AnenaX/IoT-Integrated-Automated-Gate-System/docs/L1 - GANTT.pdf

ée

# z SAE6IOM01-Mettre en place un réseau IoT répondant à un cahier des charges

Entrez le nom de la société dans la cellule B2.

Entrez le nom du chef de projet dans la cellule B3. Entrez la date de début du projet dans la cellule E3. Début du projet : l’étiquette figure dans la cellule C3. se
m

1

Le | 2 3 | 4 | 5 6 7 8 | 9 10 11 12 13 14 15 | 16 17 18 19 20 21 22 | 23 24 25 26 27 28 1 | 2 3 4 5 6 7 8 | 9 10 11 12 13 14 15 | 16 17 18 19 20 21 22
tt
e
TÂCHE | DURÉE | DÉBUT | FIN | l | m | m | j | v | s | d | l | m | m | j | v | s | d | l | m | m | j | v | s | d | l | m | m | j | v | s | d | l | m | m | j | v | s | d | l | m | m | j | v | s | d | l | m | m | j | v | s | d

ce
llu | 4/2/26 | 4/2/26

ce
llu | 4/2/26 | 4/2/26

s
lig
| | 4/2/26 | 5/2/26
| | 5/2/26 | 5/2/26
| | 5/2/26 | 6/2/26
| | 9/2/26 | 18/2/26

ce
llu
| | 19/2/26 | 25/2/26
| | 26/2/26 | 6/3/26
| | 9/3/26 | 10/3/26
| | 10/3/26 | 10/3/26
| | 10/3/26 | 15/3/26
Rédaction rapport final et oral | | 9/2/26 | 20/3/26

Exemple de bloc de titre de phase

Exemple de bloc de titre de phase

Ceci est une ligne vide.

mar, 2/3/2026

2 févr 2026 | 9 févr 2026 | 16 févr 2026 | 23 févr 2026

Début du projet :

Semaine d’affichage :

2 mars 2026 | 9 mars 2026 | 16 mars 2026

Mise en place du GANTT

Étude du systéme demandé

Cahier des charges techniques

Séléction des différents modules nécessaires

Mise en forme du devis

Liaison RPI4

Assemblage logiciels et composants

Création de la télécommande (logiciel)

Mesures et prototypage de l'ensemble

Assemblage matériel

Mesures IR (Portée et consommation)
