AnenaX/IoT-Integrated-Automated-Gate-System/docs/src/Diagramme bete a cornes.drawio.png

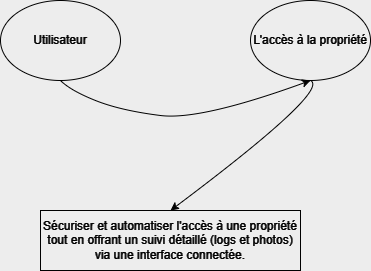
docs/src/Diagramme bete a cornes.drawio.png
