AnenaX/IoT-Integrated-Automated-Gate-System/docs/src/diagramme des exigences techniques.drawio.png

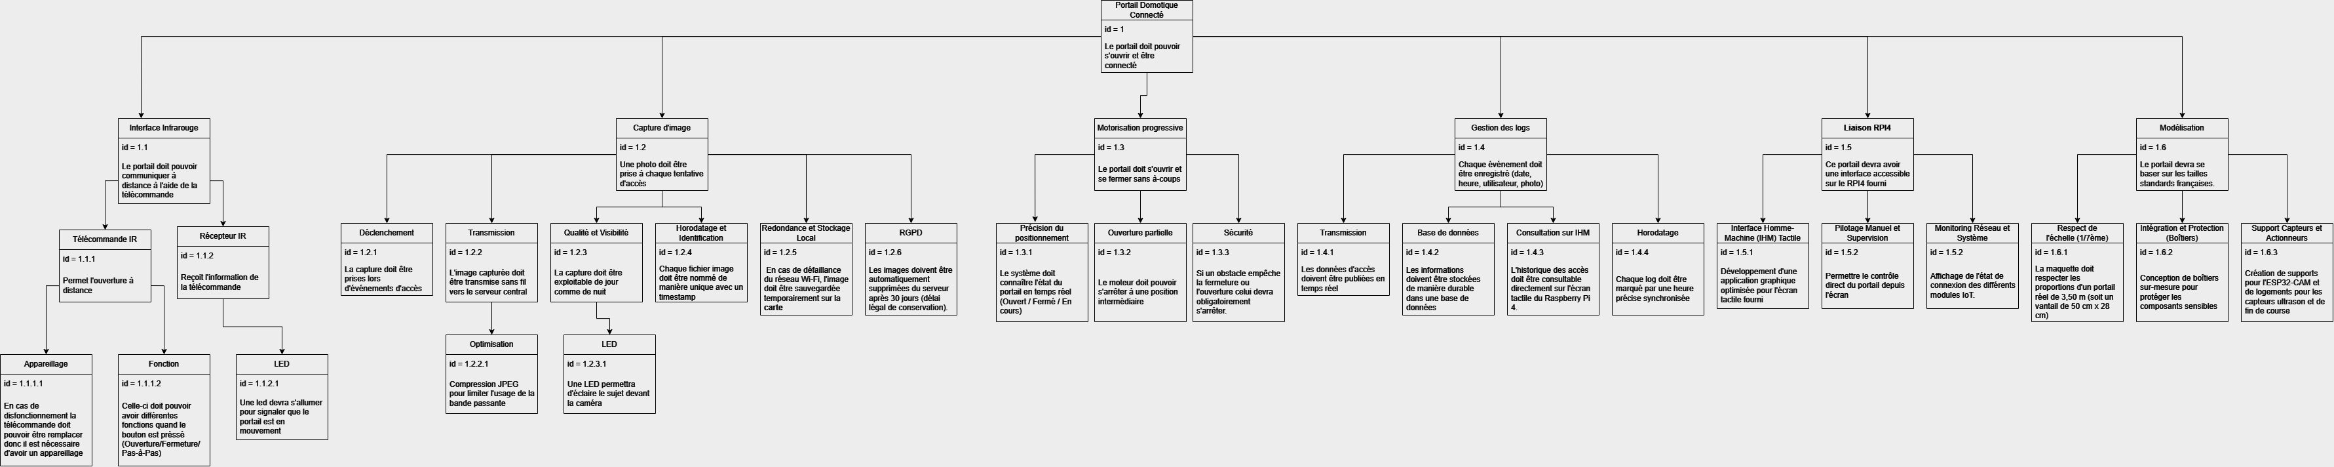
docs/src/diagramme des exigences techniques.drawio.png
