AnenaX/IoT-Integrated-Automated-Gate-System/docs/src/diagramme pieuvre.drawio.png

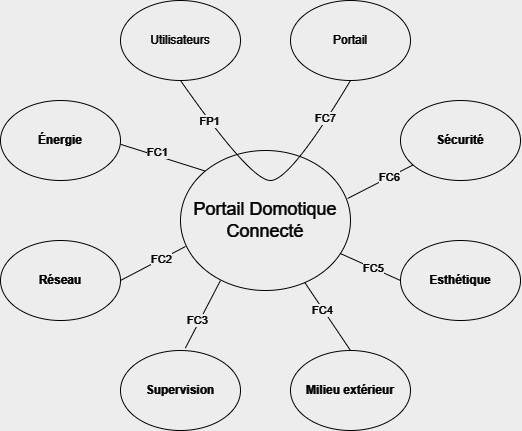
docs/src/diagramme pieuvre.drawio.png
