AnenaX/IoT-Integrated-Automated-Gate-System/docs/src/exigences-part1.png

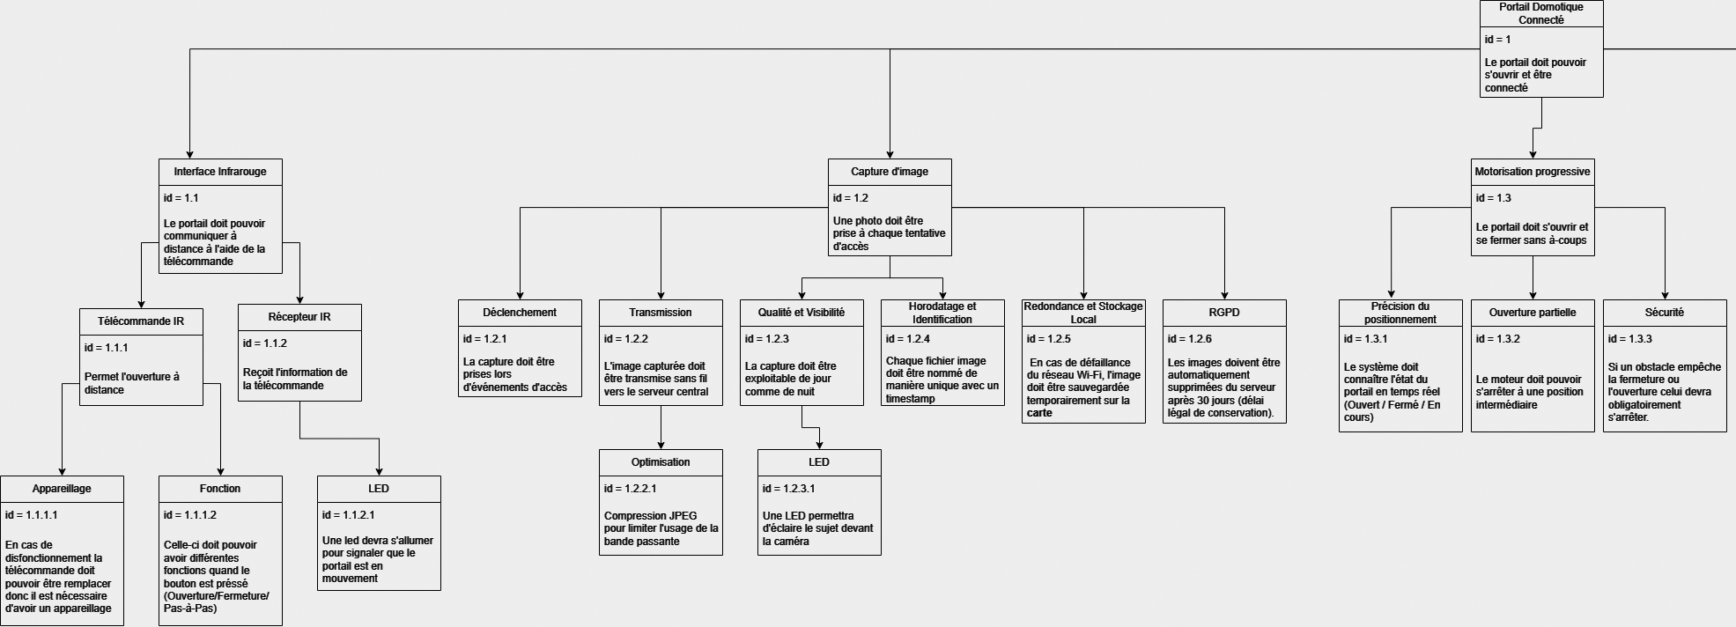
docs/src/exigences-part1.png
