AnenaX/IoT-Integrated-Automated-Gate-System/docs/src/exigences-part2.png

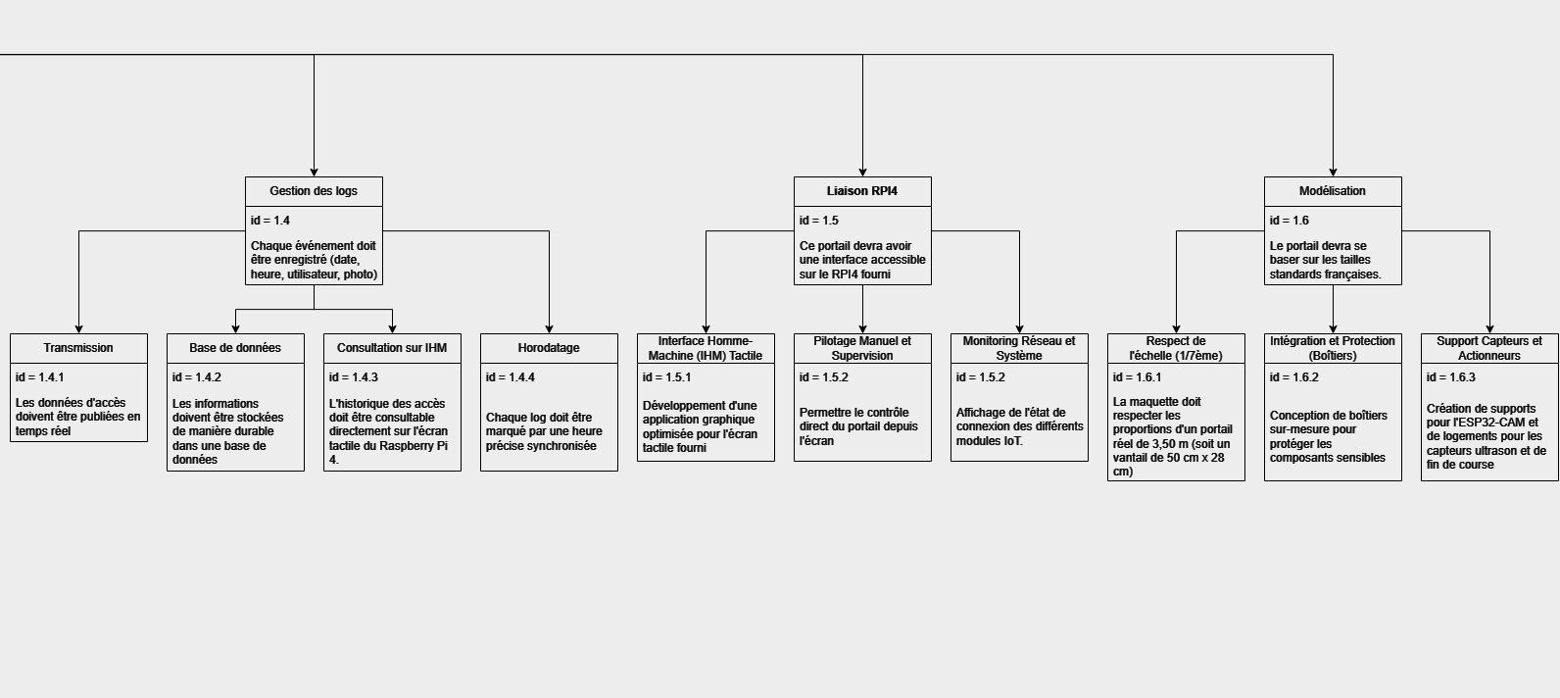
docs/src/exigences-part2.png
