AnenaX/IoT-Integrated-Automated-Gate-System/docs/src/maquette elctronique.drawio.png

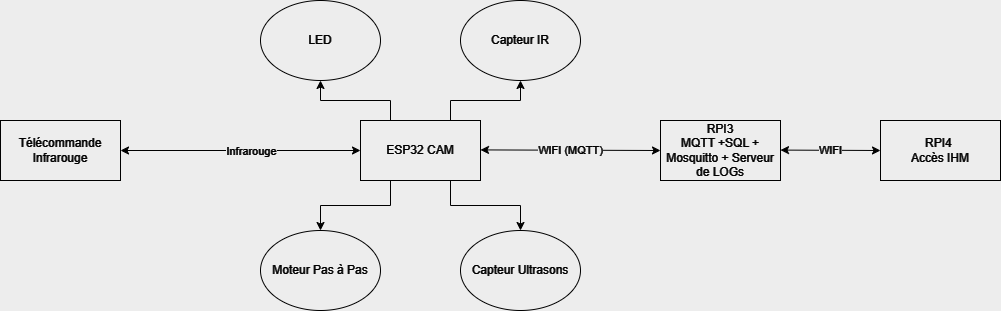
docs/src/maquette elctronique.drawio.png
