AnenaX/IoT-Integrated-Automated-Gate-System/docs/src/Rail.png

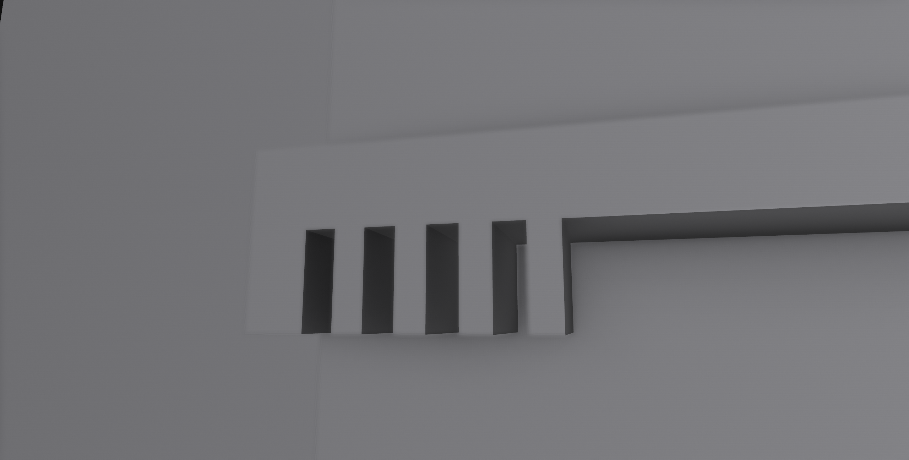
docs/src/Rail.png
