AnenaX/IoT-Integrated-Automated-Gate-System/docs/src/Rendu 3d.png

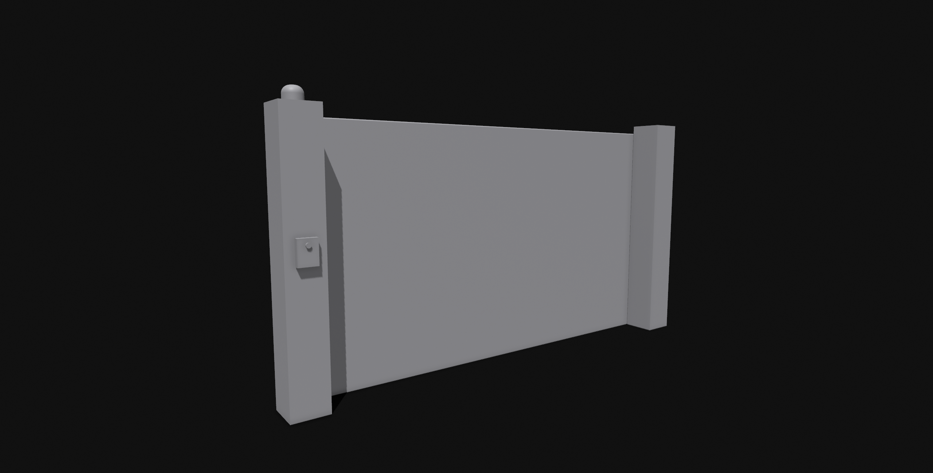
docs/src/Rendu 3d.png
