AnenaX/IoT-Integrated-Automated-Gate-System/docs/L4.5 - Materials.pdf

XXXXXXX
XXXXXXX

# Liste du matériel fourni

Modules | Quantité
RPI3 | 1
ESP32 | 1
ESP32 CAM | 2
Moteur Pas à Pas | 1
SR04M | 1
KY-022 | 1
KY-005 | 1
SD 32Go | 1
Batterie | 1

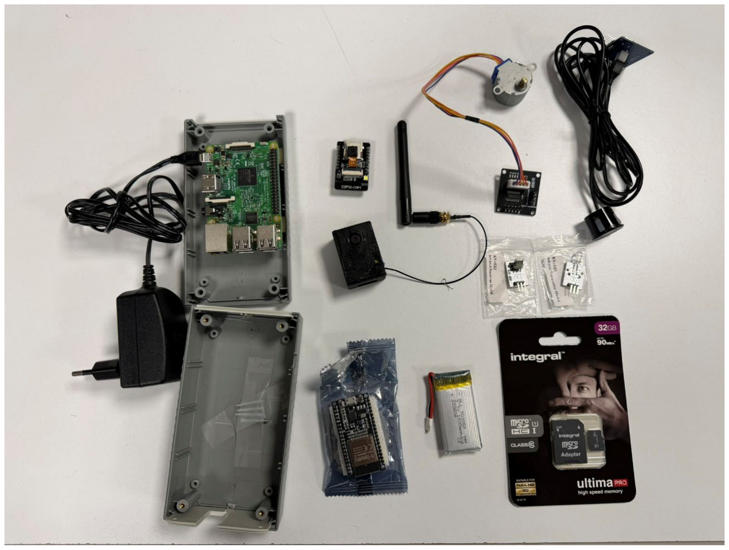
[picture p9: figure]
