AnenaX/IoT-Integrated-Automated-Gate-System/hardware/Doors/guide.stl

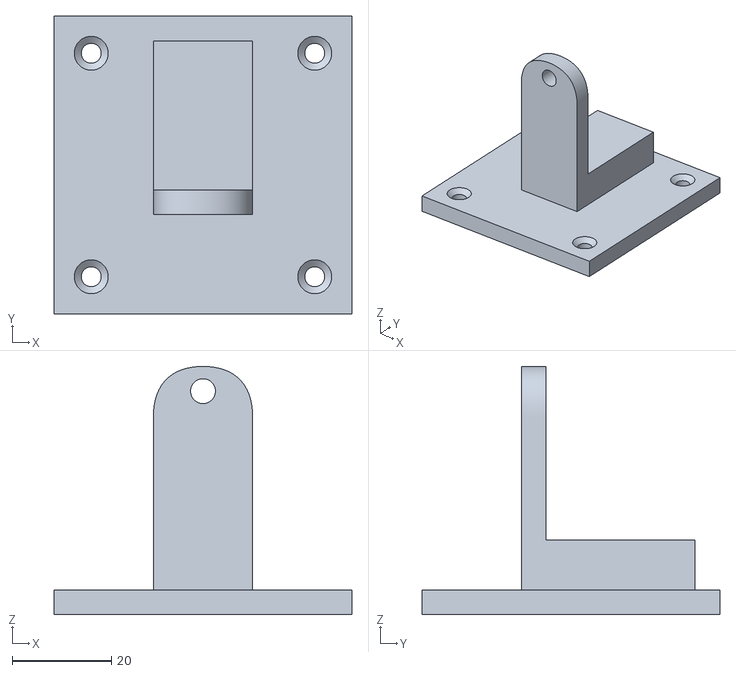
[picture p13: CAD file, 2026-03-16]
hardware/Doors/guide.stl
60.0 x 60.0 x 50.0
