AnenaX/IoT-Integrated-Automated-Gate-System/hardware/Doors/rpi case bottom.stl

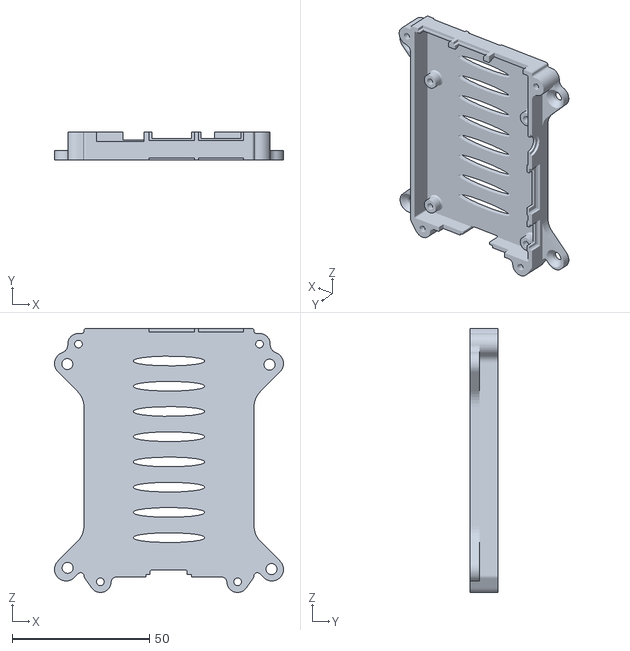
[picture p14: CAD file, 2026-03-16]
hardware/Doors/rpi case bottom.stl
83.5 x 10.3 x 96.2
