AnenaX/IoT-Integrated-Automated-Gate-System/hardware/Doors/rail 18cm.stl

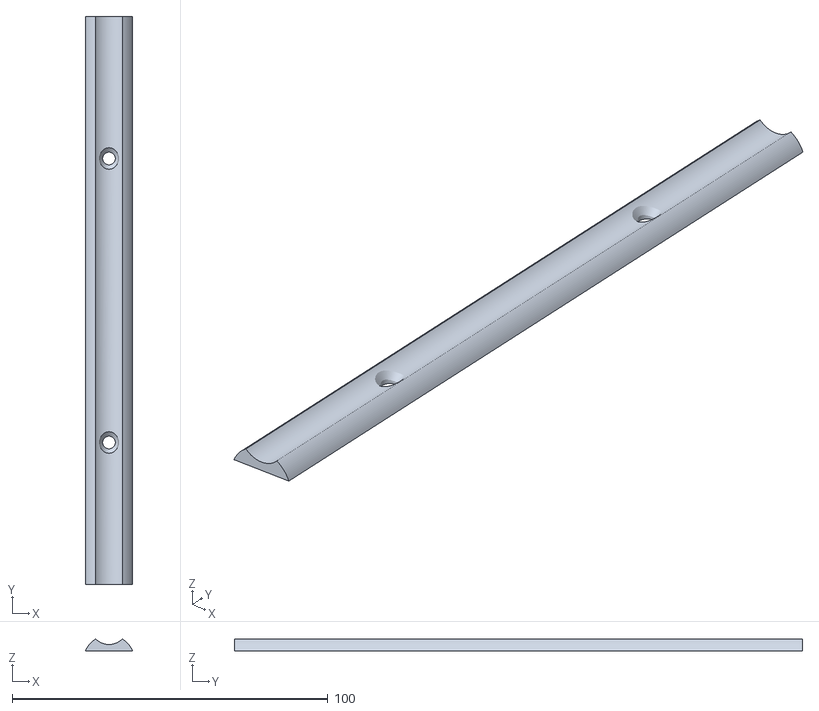
[picture p15: CAD file, 2026-03-16]
hardware/Doors/rail 18cm.stl
15.0 x 180.0 x 3.83
