AnenaX/IoT-Integrated-Automated-Gate-System/hardware/Doors/linear gear 9,2cm.stl

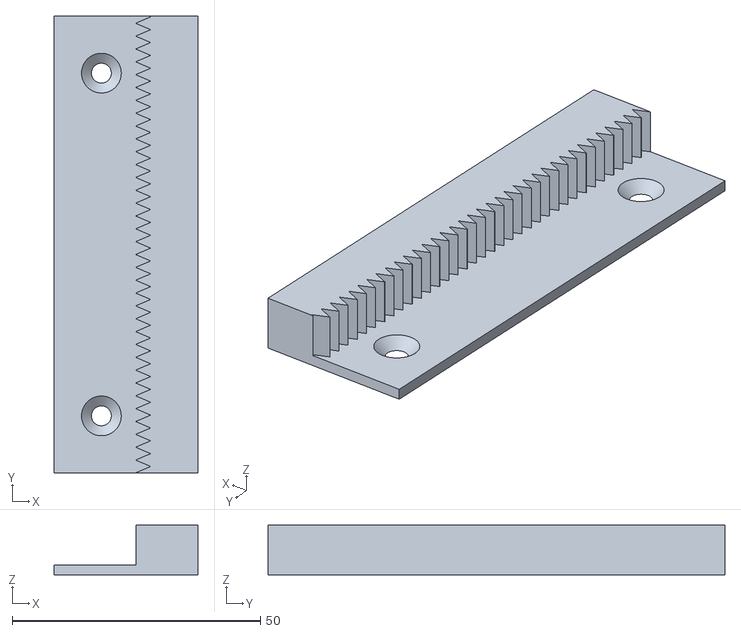
[picture p16: CAD file, 2026-03-16]
hardware/Doors/linear gear 9,2cm.stl
28.9 x 92.0 x 10.0
