AnenaX/IoT-Integrated-Automated-Gate-System/hardware/Doors/linear gear 14cm.stl

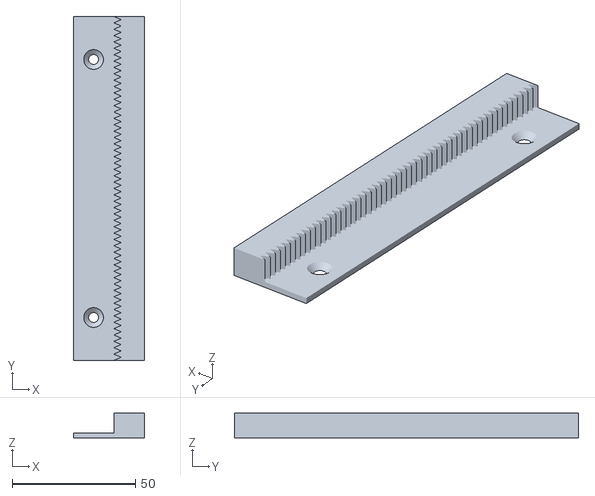
[picture p17: CAD file, 2026-03-16]
hardware/Doors/linear gear 14cm.stl
28.9 x 139.7 x 10.0
