AnenaX/IoT-Integrated-Automated-Gate-System/hardware/Doors/gear.stl

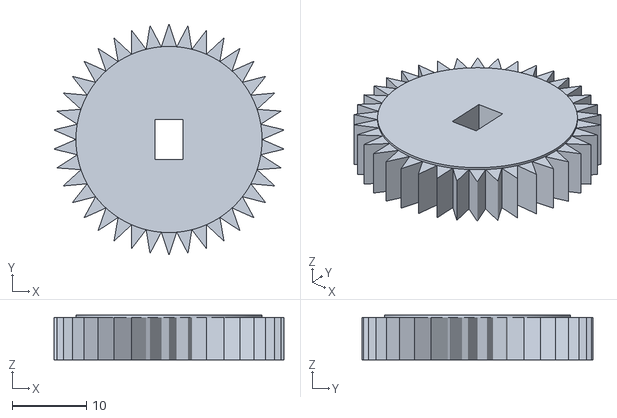
[picture p18: CAD file, 2026-03-16]
hardware/Doors/gear.stl
30.9 x 31.0 x 6.00
