AnenaX/IoT-Integrated-Automated-Gate-System/hardware/Doors/rail under the gate.stl

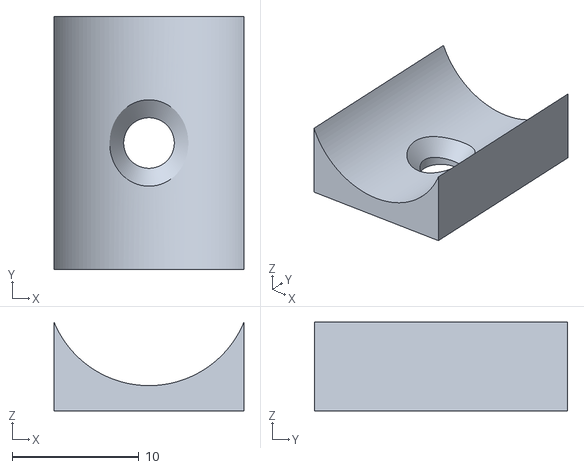
[picture p19: CAD file, 2026-03-16]
hardware/Doors/rail under the gate.stl
15.0 x 20.0 x 7.00
