AnenaX/IoT-Integrated-Automated-Gate-System/hardware/Doors/support motor.stl

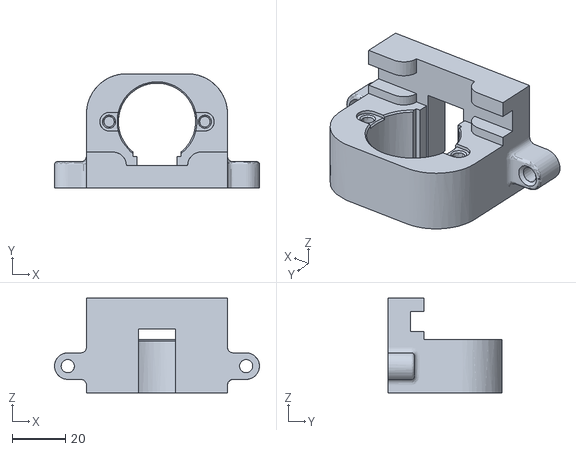
[picture p20: CAD file, 2026-03-16]
hardware/Doors/support motor.stl
77.0 x 43.0 x 35.5
