AnenaX/IoT-Integrated-Automated-Gate-System/hardware/Doors/rail 2,7cm.stl

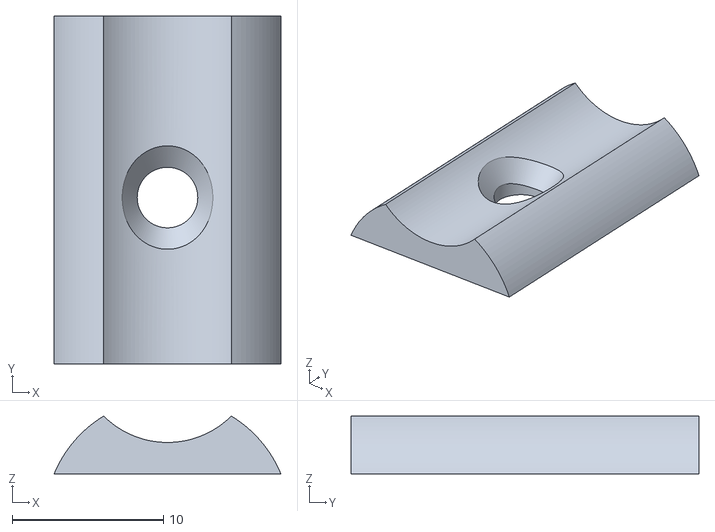
[picture p21: CAD file, 2026-03-16]
hardware/Doors/rail 2,7cm.stl
15.0 x 23.0 x 3.83
