AnenaX/IoT-Integrated-Automated-Gate-System/hardware/Doors/SR04M-Mount and KY022 Mount.3mf

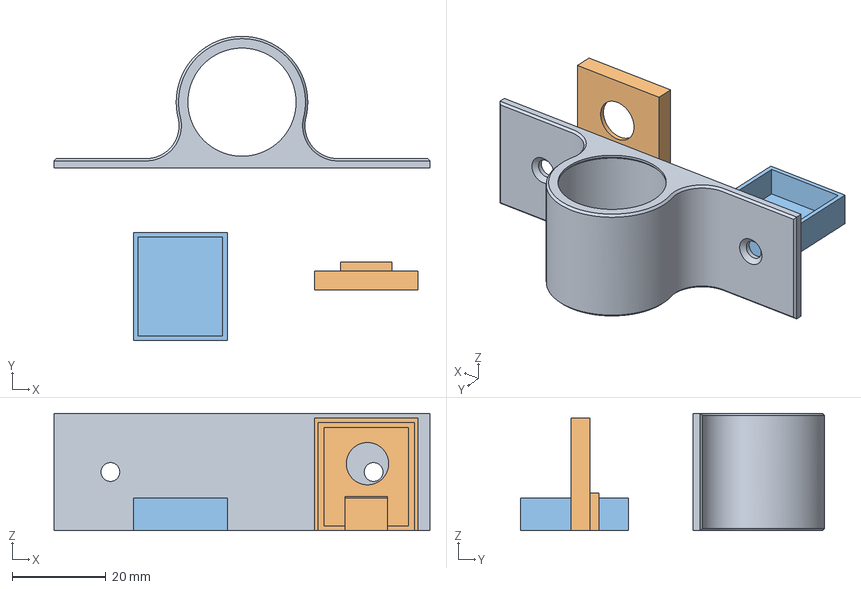
[picture p22: CAD file, 2026-03-16]
hardware/Doors/SR04M-Mount and KY022 Mount.3mf
80.0 x 64.7 x 25.0 mm
SR04M-Mount.stl
Lid.stl
Case.stl
