AnenaX/IoT-Integrated-Automated-Gate-System/(list of files, drawings)

Other design files:
hardware/Remote/PCB/Remote.fzz
