AnenaX/IoT-Integrated-Automated-Gate-System/(commit log)

2026-02-04 Initialisation de la structure du projet
2026-03-16 3D Models and MQTT Logger for RPI3
    [Remote.fzz, SR04M-Mount and KY022 Mount.3mf, gear.stl, guide.stl, linear gear 14cm.stl, linear gear 9,2cm.stl, rail 18cm.stl, rail 2,7cm.stl]
